jujuwasmydog/gh-project-dashboard/Docs_Diagrams/GH_wiring_diagram_arduino.pdf

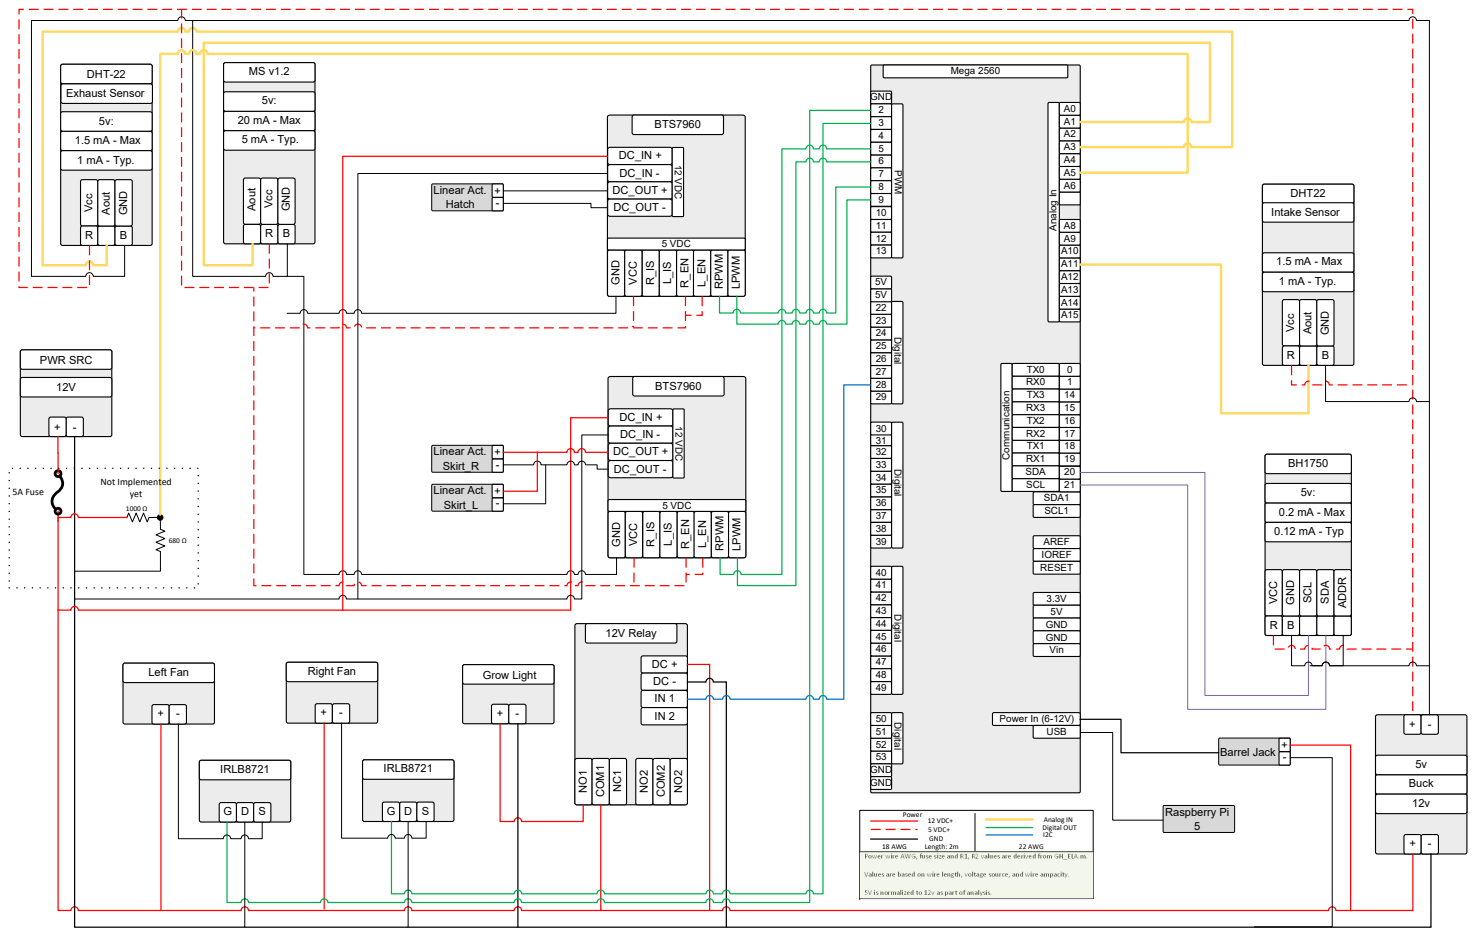
[picture p1: page 1]
Grow Light; PWR SRC; GND; Analog In; Communication; SDA1 SCL1; SDA SCL; PWM; GND GND; AREF IOREF RESET; GND GND Vin; USB; Mega 2560; Left Fan; IRLB8721; Buck; 20 mA - Max; 5 mA - Typ.; Aout; Vcc; Right Fan; DHT-22; Vcc R; 1.5 mA - Max; 1 mA - Typ.; DHT22; Intake Sensor; 0.2 mA - Max; 0.12 mA - Typ; VCC R; SCL; SDA; ADDR; Barrel Jack -; 12V Relay; COM1; COM2; Exhaust Sensor; BTS7960; RPWM; LPWM; DC_IN + DC_IN - DC_OUT + DC_OUT -; VCC; Skirt_R; Skirt_L; 12 VDC; 5 VDC; Hatch; Linear Act.; 5A Fuse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

Digital Digital Digital

Digital Power In (6-12V)

Power wire AWG, fuse size and R1, R2 values are derived from GH_ELA.m.

Values are based on wire length, voltage source, and wire ampacity.

5V is normalized to 12v as part of analysis.
