jujuwasmydog/gh-project-dashboard/(commit log)

2026-01-20 gh database
    Provide memory and storage for data published by arduino.
2026-02-08 flows.json added to remove gh-dashboard. same file; easier upload when installing
2026-02-08 removing stale file; flows.json replaces db-dashboard.json
2026-03-21 Convert dan's sketch to green cabinet & Arduino Mega
2026-03-21 linear actuator test for green cabinet
2026-03-21 update to account for board type (arduino vs mega)
2026-03-21 updated linear actuator settings
2026-03-21 cp flows_fan_pct as actual flows.json
2026-03-21 working flows.json
2026-03-22 updated flows.json to interface with real sensors; modified atmega32 sketch for arduino mega2650; updated aupload arduino to account for board types, assert control over usb and ensure node red is pr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
2026-03-22 updated Arduino_Mega..ino to support remote control as part of testing. Updated flows.json to support remote control and fault detection/display as part of testing
2026-03-23 restructured repo for ease of use, uploading arduino mega v6 firmware to handle some corner fault cases + loss of comms
2026-03-23 uploading diagram of design for arduino mega
2026-03-29 updated flows.json to match latest project icd
2026-03-30 update flows.json to allow for html support, created index.html so dashboard can be viewed via html instead of nodered; updated settings.jsto call index.html at run time
2026-04-05 added status bar to explicitly show node-red status; ws (websocket) nr (node red) ard (arduino) individual status' applied. nr relies on heartbeat from node-red flows.json
2026-04-05 updated to provide heartbeat. heartbeat needed for case where nr dies and stale data is present
2026-04-05 add throttle to provide some protection against spammed messages from arduino/nodered
2026-04-12 updated to port history from flows.json; add history tab, update filtering to parse message correctly
